noranraskin/stereo-hat/kicad/3dmodels/DC-005.STEP

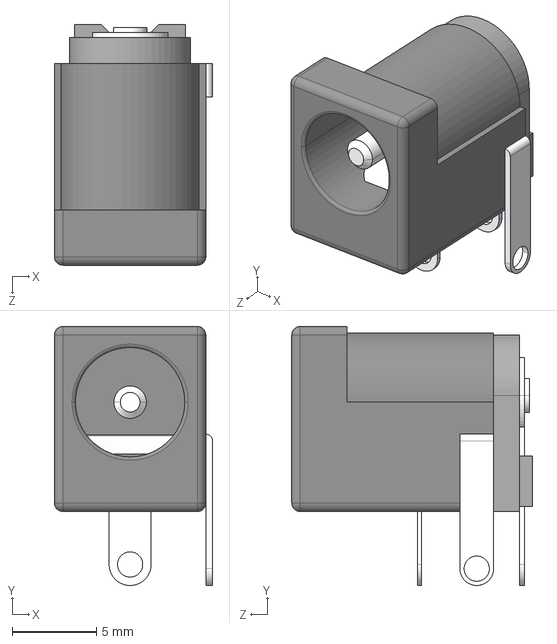
[picture p2: CAD file, 2026-10-24]
kicad/3dmodels/DC-005.STEP
9.40 x 15.4 x 14.3 mm
