noranraskin/stereo-hat/kicad/stereo.step

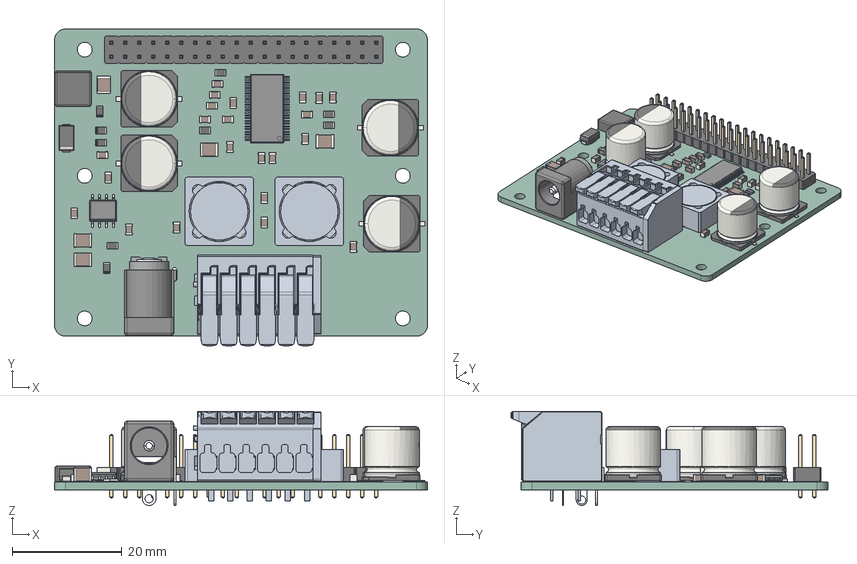
[picture p3: CAD file, 2026-10-24]
kicad/stereo.step
68.0 x 57.8 x 17.1 mm
CP_Elec_10x10 x 4
C_0805_2012Metric x 22
C_1210_3225Metric x 5
R_0805_2012Metric x 9
srf1260-100m x 2
L_Changjiang_FXL0630
BODY-TSSOP
LEAD-TSSOP x 48
PIN1
DAP
PinHeader_2x20_P254mm_Vertical
DC-005
D_SMA
BODY-SO
LEAD-D0008A x 8
stereo-unsaved-export-6sK5hk_PCB
