noranraskin/stereo-hat/kicad/3dmodels/2601-1106.igs

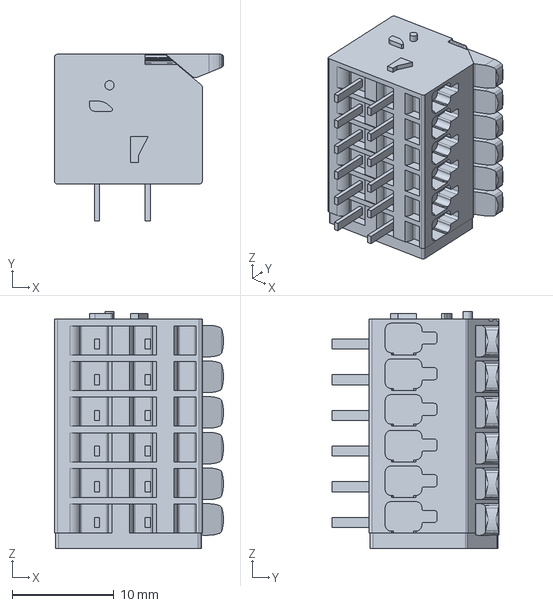
[picture p4: CAD file, 2026-10-24]
kicad/3dmodels/2601-1106.igs
16.6 x 16.4 x 23.3 mm
