noranraskin/stereo-hat/kicad/3dmodels/2601-1103.igs

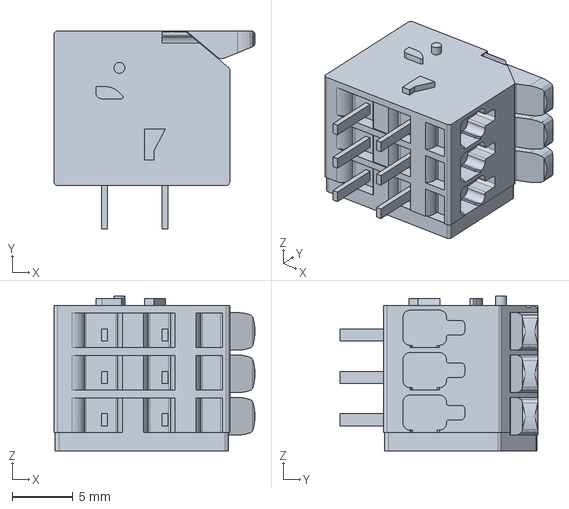
[picture p5: CAD file, 2026-10-24]
kicad/3dmodels/2601-1103.igs
16.6 x 16.4 x 12.8 mm
