noranraskin/stereo-hat/kicad/3dmodels/TAS5756MDCAR.stp

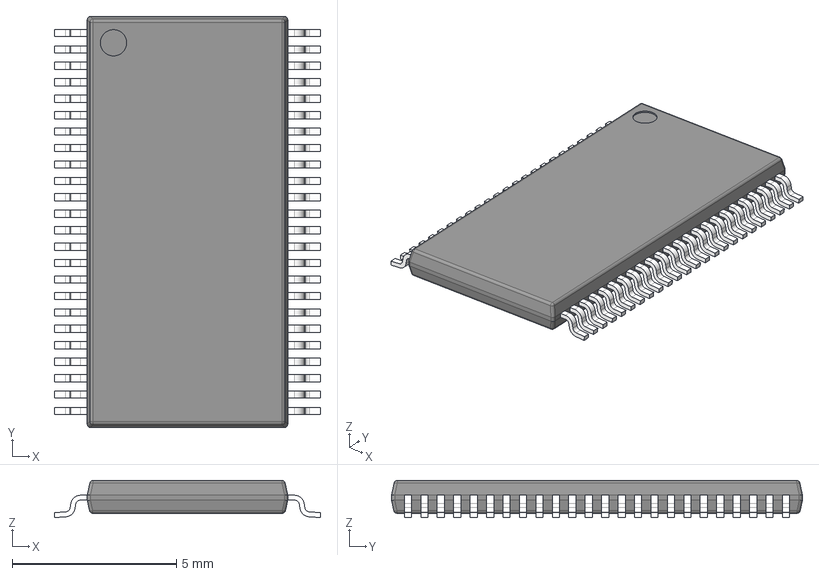
[picture p6: CAD file, 2026-10-24]
kicad/3dmodels/TAS5756MDCAR.stp
8.10 x 12.5 x 1.13 mm
BODY-TSSOP
LEAD-TSSOP x 48
PIN1
DAP
