noranraskin/stereo-hat/kicad/stereo.kicad_pcb

## KiCad design kicad/stereo.kicad_pcb (2026-10-24)

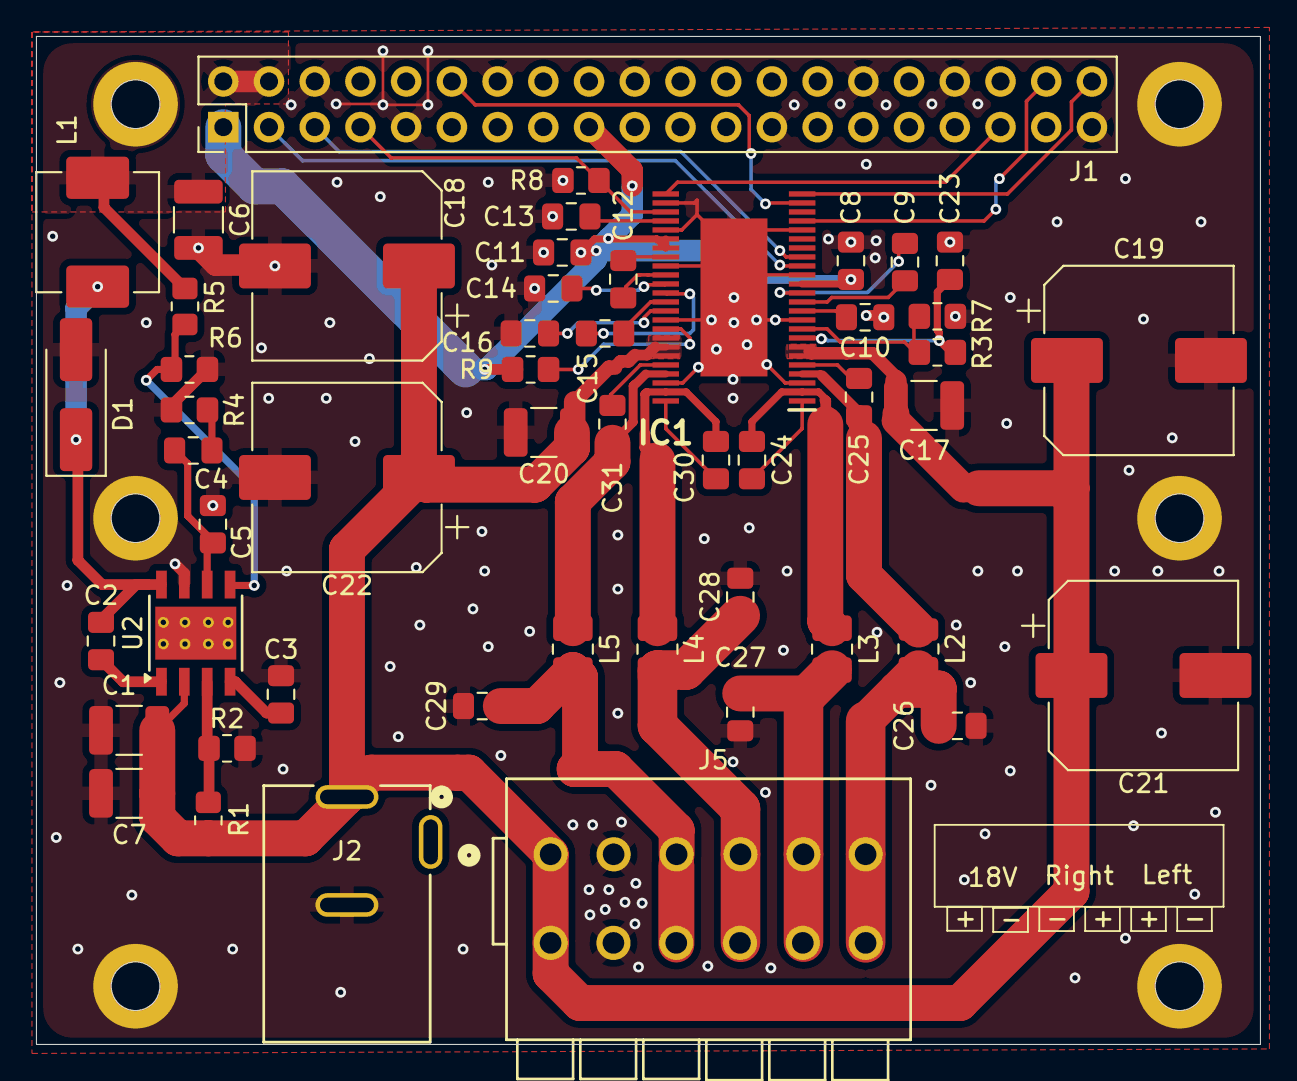
[picture p7: board stereo.kicad_pcb from above]

Board: 2 copper layers, 68.0 x 56.0 mm, 51 parts (0 on the bottom side), 43 nets.

Parts:
C1, C7, C17, C20: 22µF; C_1210_3225Metric_Pad1.33x2.70mm_HandSolder
C2: 0.1µF; C_0805_2012Metric_Pad1.18x1.45mm_HandSolder
C3: 10nF; C_0805_2012Metric_Pad1.18x1.45mm_HandSolder
C4: 180pF; C_0805_2012Metric_Pad1.18x1.45mm_HandSolder
C5: 10pF; C_0805_2012Metric_Pad1.18x1.45mm_HandSolder
C6: 47µF; C_1210_3225Metric_Pad1.33x2.70mm_HandSolder
C8, C11, C12, C13, C14, C23: 1µF; C_0805_2012Metric_Pad1.18x1.45mm_HandSolder
C9, C10, C15, C16: 2.2µF; C_0805_2012Metric_Pad1.18x1.45mm_HandSolder
C18, C19, C21, C22: 220µF; CP_Elec_10x10
C24, C25, C30, C31: 0.22µF; C_0805_2012Metric_Pad1.18x1.45mm_HandSolder
C26, C27, C28, C29: 0.68µF; C_0805_2012Metric_Pad1.18x1.45mm_HandSolder
D1: B340; D_SMA_Handsoldering
IC1: TAS5756MDCAR; SOP50P810X120-49N
J1: Raspberry_Pi_4; PinHeader_2x20_P2.54mm_Vertical
J2: DC-005-A200; JACK_DC-005-A200_XNP
J5: 2601-1106; CONN3_2601-1106_WAG
L1: 6.8µH; L_Changjiang_FXL0630
L2: L; L_1008_2520Metric
L3, L4, L5: L; L_1008_2520Metric_Pad1.43x2.20mm_HandSolder
R1: 665k; R_0805_2012Metric_Pad1.20x1.40mm_HandSolder
R2: 84.5k; R_0805_2012Metric_Pad1.20x1.40mm_HandSolder
R3, R8, R9: 150k; R_0805_2012Metric_Pad1.20x1.40mm_HandSolder
R4: 75k; R_0805_2012Metric_Pad1.20x1.40mm_HandSolder
R5: 10.2k; R_0805_2012Metric_Pad1.20x1.40mm_HandSolder
R6: 1.96k; R_0805_2012Metric_Pad1.20x1.40mm_HandSolder
R7: 390k; R_0805_2012Metric_Pad1.20x1.40mm_HandSolder
U2: TPS54232DR; TI_SO-PowerPAD-8_ThermalVias

Connections:
3.3V: C8.1, C11.1, IC1.14 (AVDD), IC1.30 (DVDD), IC1.31 (CPVDD), J1.1 (3V3), J1.17 (3V3), R9.1
5V: C6.1, J1.2 (5V), J1.4 (5V), L1.2, R5.1
GND: C1.2, C3.2, C5.2, C6.2, C7.2, C8.2, C10.1, C11.2, C13.2, C14.2, C16.2, C17.2, C18.2, C19.2, C20.2, C21.2, C22.2, C23.2, C26.2, C27.2, C28.2, C29.2, D1.2 (A), IC1.3 (PGND_1), IC1.10 (AGND_1), IC1.15 (AGND_2), IC1.20 (ADR1), IC1.26 (ADR0), IC1.29 (DGND), IC1.33 (GND), IC1.39 (PGND_2), IC1.46 (PGND_3), IC1.49 (EP), J1.6 (GND), J1.9 (GND), J1.14 (GND), J1.20 (GND), J1.25 (GND), J1.30 (GND), J1.34 (GND), J1.39 (GND), J2.2, J5.2, R2.2, R4.2, R6.2, R7.1, R8.2, U2.7 (GND)
ICSDIN: IC1.24 (SDIN), J1.40 (GPIO21/SPI1_SCLK/PCM_DOUT)
ICSDOUT: IC1.21 (GPIO2), J1.38 (GPIO20/SPI1_MOSI/PCM_DIN/PWM1)
LRCK/FS: IC1.25 (LRCK/FS), J1.35 (GPIO19/SPI1_MISO/PCM_FS)
unnamed: C4.2, R4.1
unnamed: C2.2, D1.1 (K), L1.1, U2.8 (PH)
unnamed: C25.2, IC1.5 (BSTRPA+)
unnamed: C24.2, IC1.1 (BSTRPA-)
unnamed: C31.1, IC1.44 (BSTRPB+)
unnamed: C30.1, IC1.48 (BSTRPB-)
unnamed: C12.2, IC1.34 (CN)
unnamed: C12.1, IC1.32 (CP)
unnamed: C14.1, IC1.35 (CPVSS)
unnamed: C9.2, IC1.13 (DAC_OUTA)
unnamed: C15.1, IC1.36 (DAC_OUTB)
unnamed: C13.1, IC1.28 (DVDD_REG)
unnamed: C23.1, IC1.8 (GVDD_REG), R3.2
unnamed: IC1.9 (SPK_GAIN/FREQ), R3.1, R7.2
unnamed: C9.1, IC1.12 (SPK_INA+)
unnamed: C10.2, IC1.11 (SPK_INA-)
unnamed: C15.2, IC1.37 (SPK_INB+)
unnamed: C16.1, IC1.38 (SPK_INB-)
unnamed: C25.1, IC1.4 (SPK_OUTA+), L2.1
unnamed: C24.1, IC1.2 (SPK_OUTA-), L3.1
unnamed: C31.2, IC1.45 (SPK_OUTB+), L5.1
unnamed: C30.2, IC1.47 (SPK_OUTB-), L4.1
unnamed: C2.1, U2.1 (BOOT)
unnamed: C4.1, C5.1, U2.6 (COMP)
unnamed: R1.2, R2.1, U2.3 (EN)
unnamed: C3.1, U2.4 (SS)
unnamed: R5.2, R6.1, U2.5 (VSENSE)
OUTA+: C26.1, J5.6, L2.2
OUTA-: C27.1, J5.5, L3.2
OUTB+: C29.1, J5.3, L5.2
OUTB-: C28.1, J5.4, L4.2
SCL: IC1.17 (SCL), J1.5 (SCL_I2C1/GPIO03)
SCLK: IC1.23 (SCLK), J1.12 (GPIO18/SPI1_~CE0/PCM_CLK/PWM0)
SDA: IC1.16 (SDA), J1.3 (SDA_I2C1/GPIO02)
SPK_FAULT: IC1.40 (~SPK_FAULT), R9.2
SPK_MUTE: IC1.27 (~SPK_MUTE), J1.7 (GPCLK0/GPIO04), R8.1
VIN: C1.1, C7.1, C17.1, C18.1, C19.1, C20.1, C21.1, C22.1, IC1.6 (PVDD_1), IC1.7 (PVDD_2), IC1.41 (PVDD_3), IC1.42 (PVDD_4), IC1.43 (PVDD_5), J2.1, J5.1, R1.1, U2.2 (VIN)
