noranraskin/stereo-hat/(notices)

Notices in the files:
kicad/3dmodels/2601-1106.igs:
Data from Parasolid IGES Translator 28.1.247, Copyright(c) 2006 Siemens S 1
PLM Software. All Rights Reserved. S 2
